vbaveja/parking-assist/garage_parking_enclosure/main_body.stl

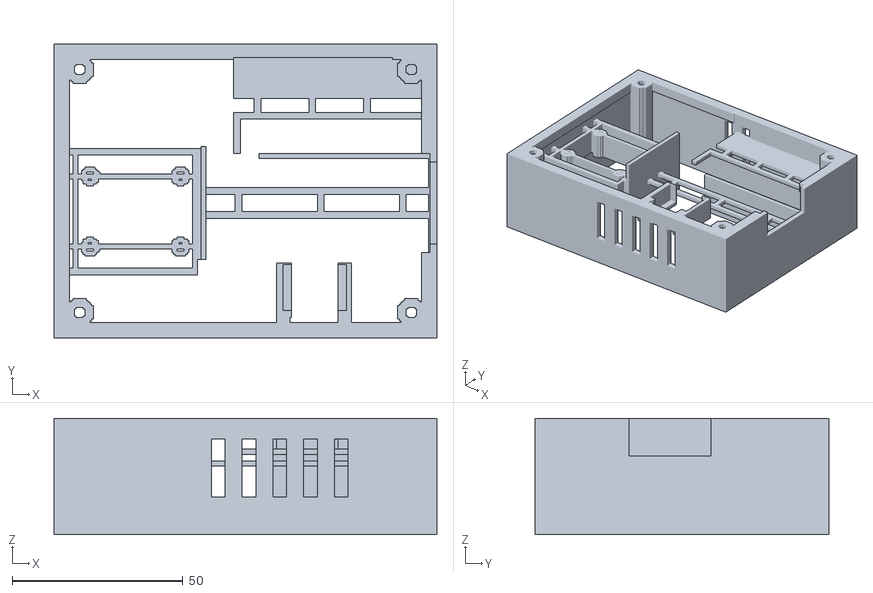
[picture p1: CAD file, 2026-10-20]
garage_parking_enclosure/main_body.stl
112.0 x 86.0 x 34.0
