vbaveja/parking-assist/garage_parking_enclosure/rear_cover.stl

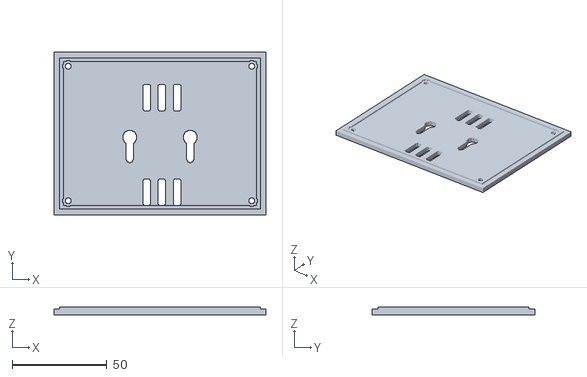
[picture p2: CAD file, 2026-10-20]
garage_parking_enclosure/rear_cover.stl
112.0 x 86.0 x 4.00
