vbaveja/parking-assist/garage_parking_enclosure/front_panel.stl

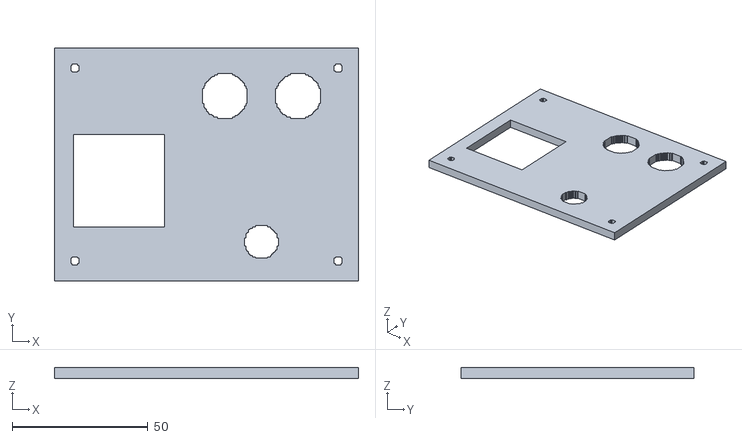
[picture p3: CAD file, 2026-10-20]
garage_parking_enclosure/front_panel.stl
112.0 x 86.0 x 4.00
